wu854065020/signal_separator/README.md

# 2023年全国大学生电子设计竞赛H题
## 简介
本项目为2023年全国大学生电子设计竞赛H题信号分离装置的参赛项目，在本次比赛中获得国一奖项。本系统可以在1s内对20kHz-100kHz的不同频正弦信号或三角波信号分离，并在题给条件下输出相位偏移，显示输入信号类型和频率，已实现题目的基本要求和发挥部分的所有功能，在发挥部分(2)之上实现了三角波的相位控制、扩大工作范围至5kHz-100kHz等。
## 系统工作流程
本系统硬件电路部分由加法器、分离电路组成，采用STM32F407VET6单片机进行控制，输出采用DDS模块AD9833。输入信号A和B经增益为1的加法器得到信号C。后级分离电路由单片机采样C信号并使用FFT分析得到A、B信号参数，控制两路DDS模块分别输出与信号A，B同频同形的偏置信号，后经放大电路和交流耦合电路输出A'和B’。单片机通过相位反馈方式，使用PID算法进行锁相环控制DDS信号频率，实现波形同频显示。
