wu854065020/signal_separator/(threads)

Thread 1 (2025-07-12):

请问您的电赛报告可以去哪里看，谢谢，正在复刻您的开源代码，由衷的感谢开源

Deng6532, 2025-07-12:

wu854065020, 2025-07-16:
我们组员正在协商其他开源部分，大概过几天就会push新开源部分。

wu854065020, 2025-07-17:
已经上传了，重新拉取就好

Deng6532, 2025-07-17:
谢谢！

---原始邮件---
发件人: ***@***.***&gt;
发送时间: 2025年7月17日(周四) 晚上6:03
收件人: ***@***.***&gt;;
抄送: ***@***.******@***.***&gt;;
主题: Re: [wu854065020/signal_separator] 请问您的电赛报告可以去哪里看，谢谢，正在复刻您的开源代码，由衷的感谢开源 (Issue #1)

wu854065020 left a comment (wu854065020/signal_separator#1)

已经上传了，重新拉取就好

—
Reply to this email directly, view it on GitHub, or unsubscribe.
You are receiving this because you authored the thread.Message ID: ***@***.***&gt;

Closed 2025-07-17.
