wu854065020/signal_separator/Core/Src/main.c

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
/* Includes ------------------------------------------------------------------*/
#include "main.h"
#include "adc.h"
#include "dma.h"
#include "spi.h"
#include "tim.h"
#include "usart.h"
#include "gpio.h"

/* USER CODE BEGIN Includes */
#include <string.h>
#include <stdio.h>
#include "sample.h"
#include "myfft.h"
#include "ad9833.h"
#include "ui_control.h"
#include "save_data.h"
/* USER CODE END Includes */


/* USER CODE BEGIN PV */
// uint8_t g_cmdToTest = 0;
AD9833_Handler ad9833Channel1;
AD9833_Handler ad9833Channel2;
// 以下变量是测试变量无需在意
uint8_t g_testAuto = 0;
float g_mainTestFreq1 = 80000.0f;
float g_mainTestFreq2 = 100000.0f;
extern float g_freqOffsetRatio[];
SaveData savaTest = {0};
/* USER CODE END PV */

void SystemClock_Config(void);
/**
  * @brief  The application entry point.
  * @retval int
  */
int main(void)
{
  /* MCU Configuration--------------------------------------------------------*/

  /* Reset of all peripherals, Initializes the Flash interface and the Systick. */
  HAL_Init();

  /* Configure the system clock */
  SystemClock_Config();

  /* Initialize all configured peripherals */
  MX_GPIO_Init();
  MX_DMA_Init();
  MX_ADC1_Init();
  MX_TIM1_Init();
  MX_USART1_UART_Init();
  MX_ADC2_Init();
  MX_ADC3_Init();
  MX_TIM2_Init();
  MX_SPI1_Init();
  MX_SPI2_Init();
  MX_USART3_UART_Init();
  MX_USART2_UART_Init();
  /* USER CODE BEGIN 2 */
  MyFFTInit();
  __HAL_UART_ENABLE_IT(&huart3, UART_IT_IDLE);
  uiControlInit();
  sampleInit();
  AD9833_Init(&ad9833Channel1, wave_sine, 100000, 0, &hspi1, GPIOA, GPIO_PIN_6);
  AD9833_Init(&ad9833Channel2, wave_sine, 100000, 0, &hspi2, GPIOC, GPIO_PIN_4);
  // autoGetFreqOffsetStart();
  /* USER CODE END 2 */

  /* Infinite loop */
  /* USER CODE BEGIN WHILE */
  while (1)
  {
    // autoGetFreqOffset();
    // if (g_testAuto) {
    //   AD9833_SetFrequency(&ad9833Channel1, g_mainTestFreq1 + g_mainTestFreq1 * g_freqOffsetRatio[0]);
    //   AD9833_SetFrequency(&ad9833Channel2, g_mainTestFreq2 + g_mainTestFreq2 * g_freqOffsetRatio[1]);
    //   HAL_Delay(1000);
    // }
    sampleLoop(); // 状态机循环函数
//    AD9833_SetFrequency(&ad9833Channel1, g_testFreq);
//    // AD9833_SetFrequency(&ad9833Channel2, g_testFreq);
//    HAL_Delay(1000);
    /* USER CODE END WHILE */

    /* USER CODE BEGIN 3 */
  }
  /* USER CODE END 3 */
}

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
/* USER CODE BEGIN 4 */
/* retarget the C library printf function to the USART */
int fputc(int ch, FILE *f)
{
    HAL_UART_Transmit(&huart1, (uint8_t *)&ch, 1, 0xFFFF);
    return ch;
}
/* USER CODE END 4 */
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
