wu854065020/signal_separator/signal_separator.ioc

Mcu.UserName=STM32F407VETx
PA0-WKUP.Signal=ADCx_IN0
PA1.Signal=ADCx_IN1
PA10.Signal=USART1_RX
PA13.Signal=SYS_JTMS-SWDIO
PA14.Signal=SYS_JTCK-SWCLK
PA15.GPIO_Label=KEY1
PA15.Signal=GPIO_Input
PA2.Signal=ADCx_IN2
PA6.Signal=GPIO_Output
PA7.Signal=SPI1_MOSI
PA9.Signal=USART1_TX
PB0.Signal=GPIO_Output
PB10.Signal=SPI2_SCK
PB3.Signal=SPI1_SCK
PB4.Signal=SPI1_MISO
PC0.Signal=GPIO_Output
PC1.Signal=GPIO_Output
PC13-ANTI_TAMP.Signal=GPIO_Output
PC2.Signal=SPI2_MISO
PC3.Signal=SPI2_MOSI
PC4.Signal=GPIO_Output
PC5.Signal=GPIO_Output
PD5.Signal=USART2_TX
PD6.Signal=USART2_RX
PD8.Signal=USART3_TX
PD9.Signal=USART3_RX
PH0-OSC_IN.Signal=RCC_OSC_IN
PH1-OSC_OUT.Signal=RCC_OSC_OUT
