wu854065020/signal_separator/User/Inc/blackmanharris2048.h

/*
 * @Author: wzccccccc
 * @Date: 2023-08-02 18:30:10
 * @LastEditors: wzccccccc wu854065020@gmail.com
 * @LastEditTime: 2024-04-01 14:40:03
 * @FilePath: \signal_separator\User\Inc\blackmanharris2048.h
 */
#ifndef BLACKMANHARRIS2048_H_
#define BLACKMANHARRIS2048_H_

const float blackmanHarris2048[2048] = {
0.000060000,0.000060133,0.000060533,0.000061200,0.000062133,0.000063334,0.000064802,0.000066537,
0.000068542,0.000070815,0.000073357,0.000076170,0.000079254,0.000082610,0.000086238,0.000090140,
0.000094317,0.000098770,0.000103500,0.000108508,0.000113796,0.000119366,0.000125218,0.000131354,
0.000137776,0.000144486,0.000151486,0.000158776,0.000166360,0.000174240,0.000182416,0.000190893,
0.000199671,0.000208753,0.000218141,0.000227839,0.000237848,0.000248171,0.000258810,0.000269770,
0.000281051,0.000292658,0.000304593,0.000316859,0.000329459,0.000342397,0.000355676,0.000369299,
0.000383269,0.000397590,0.000412266,0.000427301,0.000442697,0.000458458,0.000474589,0.000491094,
0.000507976,0.000525240,0.000542889,0.000560928,0.000579361,0.000598193,0.000617428,0.000637070,
0.000657124,0.000677594,0.000698487,0.000719805,0.000741554,0.000763740,0.000786366,0.000809439,
0.000832963,0.000856943,0.000881385,0.000906295,0.000931677,0.000957537,0.000983881,0.001010715,
0.001038043,0.001065873,0.001094210,0.001123059,0.001152428,0.001182321,0.001212746,0.001243708,
0.001275214,0.001307271,0.001339883,0.001373059,0.001406805,0.001441128,0.001476033,0.001511529,
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
0.037922715,0.038335003,0.038750665,0.039169716,0.039592174,0.040018056,0.040447378,0.040880157,
0.041316410,0.041756153,0.042199404,0.042646180,0.043096496,0.043550370,0.044007819,0.044468859,
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
};


#endif
