wu854065020/signal_separator/User/Inc/key.h

/*
 * @Author: wzccccccc
 * @Date: 2023-08-30 16:58:21
 * @LastEditors: wzccccccc wu854065020@gmail.com
 * @LastEditTime: 2024-04-01 14:40:09
 * @FilePath: \signal_separator\User\Inc\key.h
 */
#ifndef KEY_H_
#define KEY_H_

#include "main.h"

uint8_t key_scan(void); 



#endif
