wu854065020/signal_separator/User/Inc/ui_control.h

/*
 * @Author: wzccccccc
 * @Date: 2023-08-30 16:58:21
 * @LastEditors: wzccccccc wu854065020@gmail.com
 * @LastEditTime: 2024-04-01 14:40:44
 * @FilePath: \signal_separator\User\Inc\ui_control.h
 */
#ifndef UI_CONTROL_H_
#define UI_CONTROL_H_

#include "stm32f4xx_hal.h"

typedef __packed struct
{
    uint8_t head;
    uint8_t phase;
    uint8_t enable;
    uint8_t tail[3];
} PhaseControlFrame;
#define PHASE_CONTROL_HEAD 0xA1
#define PHASE_CONTROL_LENGTH sizeof(PhaseControlFrame)

typedef __packed struct
{
    uint8_t head;
    uint8_t wave;
    uint8_t enable;
    uint8_t offset;
    uint8_t tail[3];
}TestControlFrame;
#define TEST_CONTROL_HEAD 0xA2
#define TEST_CONTROL_LENGTH sizeof(TestControlFrame)



void uiControlInit(void);
void uiUartCallBack(void);
void uiSendWaveInf(uint32_t wave1Freq, uint32_t wave2Freq, uint8_t wave1Type, uint8_t wave2Type);
void uiSendOffset(int8_t offset1, int8_t offset2);

#endif
