wu854065020/signal_separator/User/Inc/sample_config.h

/*
 * @Author: wzccccccc
 * @Date: 2023-08-02 17:53:21
 * @LastEditors: wzccccccc wu854065020@gmail.com
 * @LastEditTime: 2024-04-01 15:04:40
 * @FilePath: \signal_separator\User\Inc\sample_config.h
 */
#ifndef SAMPLE_CONFIG_H_
#define SAMPLE_CONFIG_H_

#define SIGNAL_NUM 1024 // 分析信号成分采用1024点FFT
#define FFT_NUM SIGNAL_NUM
#define SAMPLE_FREQ 1024000
#define PHASE_LOCKED_FFT_NUM 256 // 锁相环采用256点FFT

#endif
