wu854065020/signal_separator/(commit log)

2023-08-02 fft完成，正在分析波形
2023-08-02 成功获取谐波分量
2023-08-02 软件检测波形和频率OK！！！
2023-08-02 先保存下，大改
2023-08-03 数字锁相完成
2023-08-03 修改了一个下标越界bug
2023-08-03 单路还原信号成功，添加了频票偏置
2023-08-03 实测高频低频跟随都很好，且已论证两个输出的相位差基本稳定，可以开始测相位
2023-08-03 启动键完成
2023-08-03 倍频相位正写到一半，先睡觉
2023-08-04 初相位接近成功
2023-08-04 初相位完成，但需要调下pid，ui交互完成
2023-08-04 结构完全搭完，正在完善自动设置频偏
2023-08-04 自动频偏获取完成，等待整合进工程中
2023-08-04 自动调节完成
2023-08-05 最终版本，无敌
2025-07-17 上传电赛报告
